XadielM/Xadiel_Martinez_PLC4Uni/Tarea 4/Imagenes/PLC4UNI Demo.png

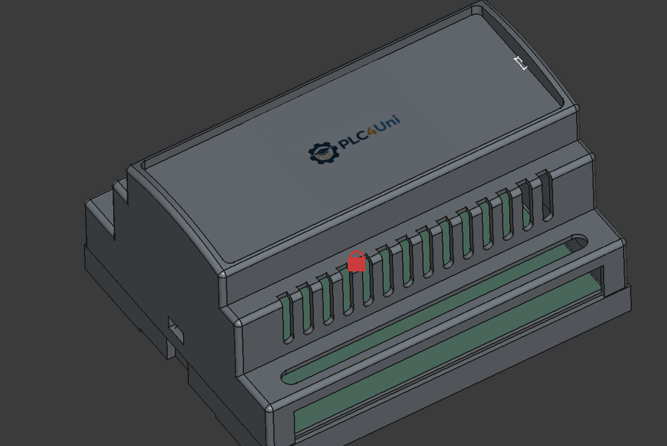
Tarea 4/Imagenes/PLC4UNI Demo.png
