XadielM/Xadiel_Martinez_PLC4Uni/Tarea 5/Etiqueta frontal.jpg

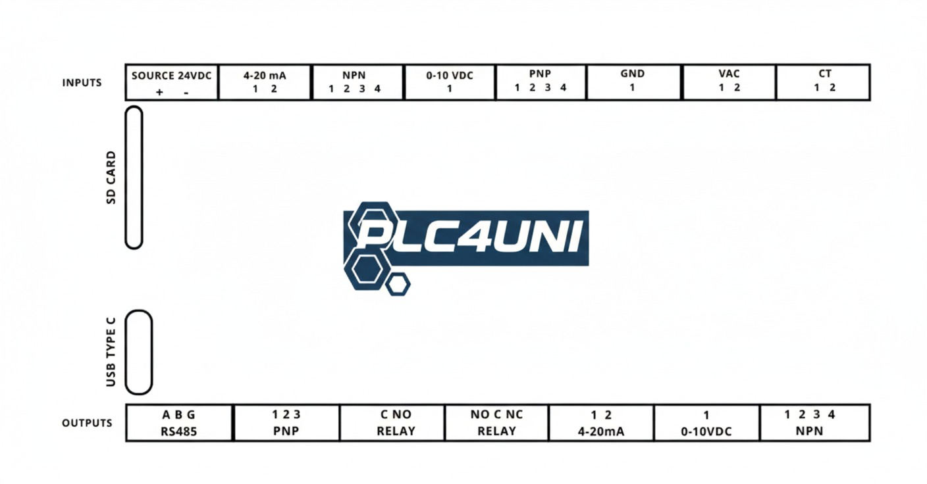
Tarea 5/Etiqueta frontal.jpg
