XadielM/Xadiel_Martinez_PLC4Uni/Tarea 5/Etiqueta lateral.png

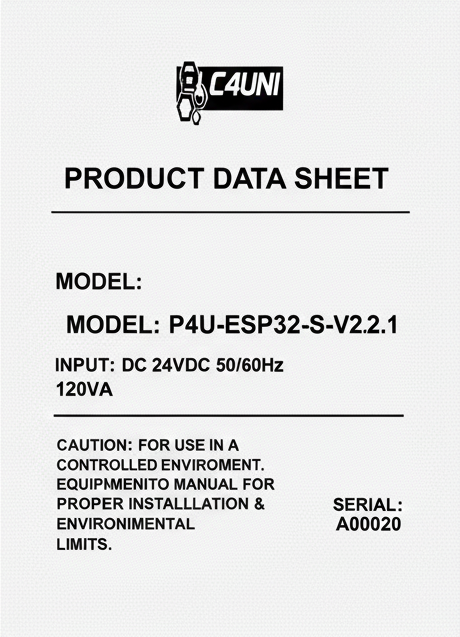
Tarea 5/Etiqueta lateral.png
