XadielM/Xadiel_Martinez_PLC4Uni/Tarea 2/Diseño del plastic case/FreeCAD/Plastic Case PT1.FCStd

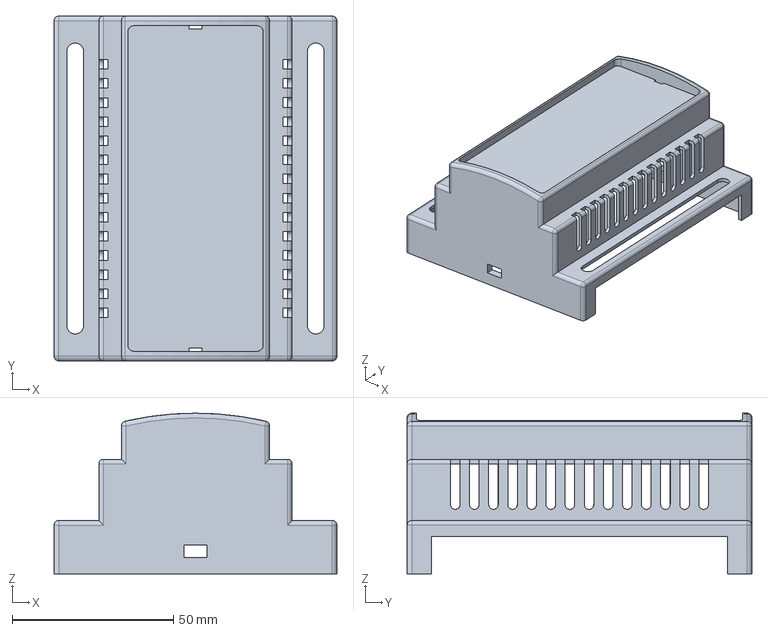
[picture p10: CAD file, 2025-10-10]
Tarea 2/Diseño del plastic case/FreeCAD/Plastic Case PT1.FCStd
87.7 x 107.0 x 49.8 mm
