XadielM/Xadiel_Martinez_PLC4Uni/Tarea 2/Diseño del plastic case/FreeCAD/Plastic Case PT2.FCStd

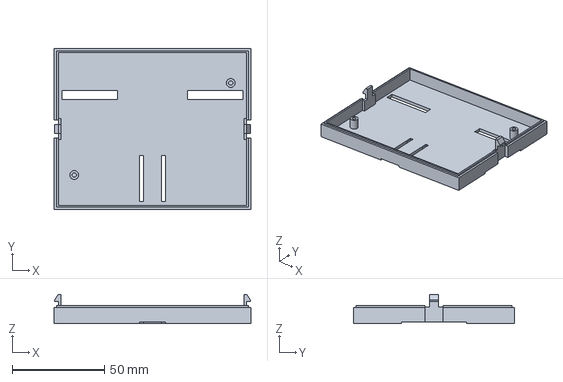
[picture p11: CAD file, 2025-10-03]
Tarea 2/Diseño del plastic case/FreeCAD/Plastic Case PT2.FCStd
107.0 x 87.7 x 16.0 mm
