XadielM/Xadiel_Martinez_PLC4Uni/Tarea 2/Diseño del plastic case/FreeCAD/Plastic Case PT3.FCStd

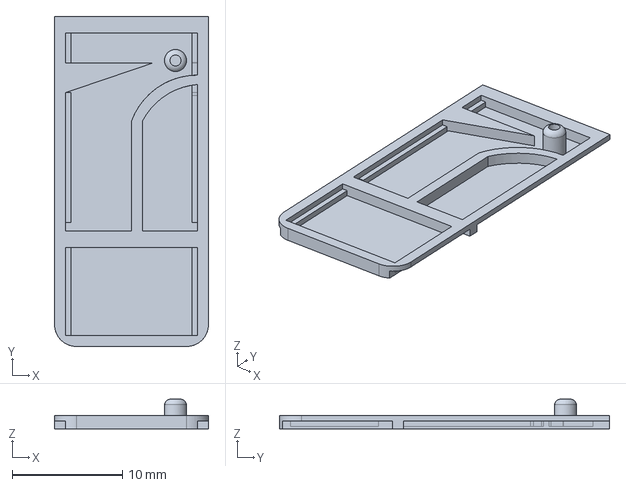
[picture p12: CAD file, 2025-10-03]
Tarea 2/Diseño del plastic case/FreeCAD/Plastic Case PT3.FCStd
14.0 x 30.0 x 2.70 mm
