XadielM/Xadiel_Martinez_PLC4Uni/(list of files, cad)

Other CAD files:
Tarea 4/Assembly.FCStd
Tarea 6/Assembly.FCStd
