XadielM/Xadiel_Martinez_PLC4Uni/Tarea 5/PLC4UNI Manual Edicion 1.0.docx

Manual de uso Edición 1.0

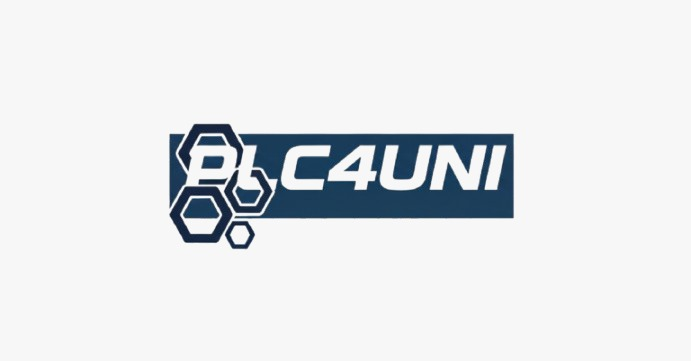
[picture p13: figure]

Gracias por elegir PLC4UNI para tus proyectos universitarios y/o personales, en este manual encontrarás todo lo relacionado al PLC para poder aprovechar sus capacidades al máximo.

# Introducción

## Descripción

PLC4UNI es un PLC de código abierto enfocado en el ámbito educación superior desarrollado por estudiantes del Instituto Tecnológico de Las Américas (ITLA). De ahí es donde viene el nombre PLC4UNI o PLC for University lo cual significa PLC para Universidad.

El PLC utiliza ESP32 como CPU, logrando así un dispositivo de automatización compacta y de código abierto. Gracias al ESP32 el cual es un microcontrolador potente también brinda buena conectividad WiFi y Bluetooth para aplicaciones de la industria 4.0 y IoT (Internet of Things). El sistema completo esta integrado en una PCB diseñada a medida, que incorpora las entradas y salidas y asegura la protección y fiabilidad de las señales.

## Proposito del dispositivo

Este dispositivo busca ser de costo asequible para los estudiantes debido a su enfoque educativo sin quitarle su funcionalidad básica de un PLC industrial, este es el dispositivo perfecto como introducción a PLC para estudiantes.

## Definiciones, acrónimos y abreviaturas

PLC: (Programmable Logic Controller) Dispositivo robusto que automatiza tareas comúnmente usado en el área industrial, como puede ser: controlar máquinas, motores eléctricos, etc.

IoT: Es una red de objetos conectados a internet que mediante software y sensores son capaces de recopilar, intercambiar datos y actuar de forma inteligente, los cuales van desde electrodomésticos hasta maquinas industriales para automatizar tareas.

PCB: (Printed Circuit Board). Es una placa plana hecha de material aislante con pistas de material conductor en la superficie, mayormente de cobre. Esta placa se conoce como la base mediante la cual se conectan y se montan los componentes electrónicos.

CPU: (Central Processing Unit). Es el cerebro de una computadora, lo que significa que es el componente principal que ejecuta instrucciones, realiza cálculos y gestiona las tareas de un dispositivo.

ESP32: Es un microcontrolador de bajo costo que cuenta con conectividad Bluetooth y WiFi

Microcontrolador: Es una pequeña computadora diseñada para ejecutar tareas específicas de forma autónoma.

Din rail: Barra metálica estandarizada, principalmente de acero, utilizada para montar de forma rápida y organizada componentes eléctricos y de automatización

## Propósito del manual

Este documento esta enfocado a estudiantes de ingeniería, técnicos y personas entusiastas los cuales estén interesados en entender y programar este dispositivo. Tiene como propósito ser una guía concisa y práctica para el inicio de forma segura y eficiente del PLC, desde las conexiones hasta la ejecución del primer programa.

## Características principales

Conectividad: Increíble capacidad inalámbricas gracias al ESP32 que cuenta con WiFI 802.11 b/g/n y Bluetooth v4.2.

Diseño robusto: PCB diseñada para aplicaciones educativas que cuenta con buena resistencia para tareas con nivel medio de demanda y que cuenta con terminales de tornillo y din rail para instalación en cualquier tipo de panel.

Nucleo de alto rendimiento: Gracias al ESP32 que cuenta con doble núcleo a 240MHz.

# Arquitectura y Hardware

## Bloques del sistema

El sistema se compone de tres secciones principales los cuales interactúan con la CPU, los cuales son, alimentación, Interfaz de entrada y interfaz de salida.

    - Alimentación: Es la que proporciona la energía necesaria para el sistema lógico, a las entradas y salidas. Es lo que hace que todos los componentes funcionen.
    - Interfaz de entrada: Recibe y acondiciona las señales y las lleva al nivel lógico que tiene el ESP32 para ser procesadas y ejecutar acciones según las instrucciones que tenga.
    - Interfaz de salida: Luego del ESP32 procesar las señales, manda señales a estas salidas según las instrucciones que tenga el PLC.

## Especificaciones técnicas

Alimentación I/O: La alimentación general son 24V y al ESP32 son 3.3V, lo indicado por el manual del ESP.

Entradas digitales: Tenemos distintos tipos de entradas, desde simples entradas PNP hasta entradas optocupladas, entre otras.

Salidas digitales: De igual formas encontramos una buena variedad de salidas, desde RS485 hasta salidas a Relay y 0-10V.

Dimensiones de la PCB:

- Circuito del USB: Largo 44.5 x Ancho16 mm
- Circuito principal: Largo 99.9 x Ancho 80.1 mm

# Input Interface

## Entradas

Pin Number | Label | Función o Descripción
1 | 24V | Alimentación 24V
2 | GND | Tierra
3 | 4-20mA | Entrada de corriente 4-20mA
4 | GND | Tierra
5 | NPN_IN | Entrada NPN
6 | NPN_IN | Entrada NPN
7 | NPN_IN | Entrad NPN
8 | NPN_IN | Entrada NPN
9 | 0-10V | Entrada de voltaje 0-10V
10 | PNP_IN | Entrada PNP
11 | PNP_IN | Entrada PNP
12 | PNP_IN | Entrada PNP
13 | PNP_IN | Entrada PNP
14 | GND | Tierra
15 | VAC1 | Entrada Voltaje AC
16 | VAC2 | Entrada Voltaje AC
17 | CT1 | EntradaCT
18 | CT2 | Entrada CT

## Salidas:

Pin Number | Label | Función o Descripción
1 | RS485_A | Transmisión serial RS485
2 | RS485_B | Transmisión serial RS485
3 | GND | Tierra
4 | PNP_OUT | Salida PNP
5 | PNP_OUT | Salida PNP
6 | PNP_OUT | Salida PNP
7 | NO_B_RLY | Relay B Normally Open
8 | COM_B_RLY | Relay B Comun
9 | NC_B_RLY | Relay B Normally Closed
10 | COM_A_RLY | Relay A comun
11 | NO_RLY | Relay A Normall Open
12 | 4-20mA | Salida corriente 4-20mA
13 | GND | Tierra
14 | 0-10V | Salida de voltaje 0-10V
15 | NPN_OUT | Salida NPN
16 | NPN_OUT | Salida NPN
17 | NPN_OUT | Salida NPN
18 | NPN_OUT | Salida NPN

# Funcionalidades Avanzadas

## Conectividad inalámbrica

- Servidor Web: Ideal para cambiar o monitorear el estado de las Entradas y Salidas desde un navegador.
- Protocolo MQTT: Sirve para enviar datos de entrada a la nube o a un sistema SCADA.
- Modbus TCP/IP: Implementación de protocolos industriales estándar sobre WiFi.

## Modos especiales

Entradas Analógicas: Aunque las mayorías de las entradas del ESP son digitales con los pines analógicos que tiene el microcontrolador pueden ser usados para sensores que se regulan de 0 a 3.3V (voltaje máximo 3.3 para el uso correcto y evitar dañar el ESP).

PWM: El ESP32 soporta PWM en varios de sus pines lo cual permite controlar diferentes velocidades de motores y hasta la intensidad de luces, entre otras diferentes aplicaciones que se podrían hacer con esta función.

# Mantenimiento básico

Revisión. Asegurarse siempre que las terminales de tornillos estén bien ajustadas y que luzcan en buenas condiciones antes de conectar cualquier cosa.

Limpieza. Siempre es muy importante mantener la PCB libre de polvo y humedad. También mantener alejado de zonas muy calurosas para así evitar daños internos tanto a conexiones como a componentes.

Seguridad. Desconectar siempre la alimentación a 24V antes de mover o hacer algún tipo de ajuste en alguna entrada o salida.

# Bibliografías

PLC4UNI

https://github.com/XadielM/Xadiel_Martinez_PLC4Uni.git

Espressif https://www.espressif.com/sites/default/files/documentation/esp32_datasheet_en.pdf

ESP32 Datasheet

https://www.alldatasheet.com/view.jsp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
