XadielM/Xadiel_Martinez_PLC4Uni/Tarea 3/Diseño PCB/PLC4UNI/PLC4UNI.kicad_pcb

## KiCad design Tarea 3/Diseño PCB/PLC4UNI/PLC4UNI.kicad_pcb (2025-12-11)

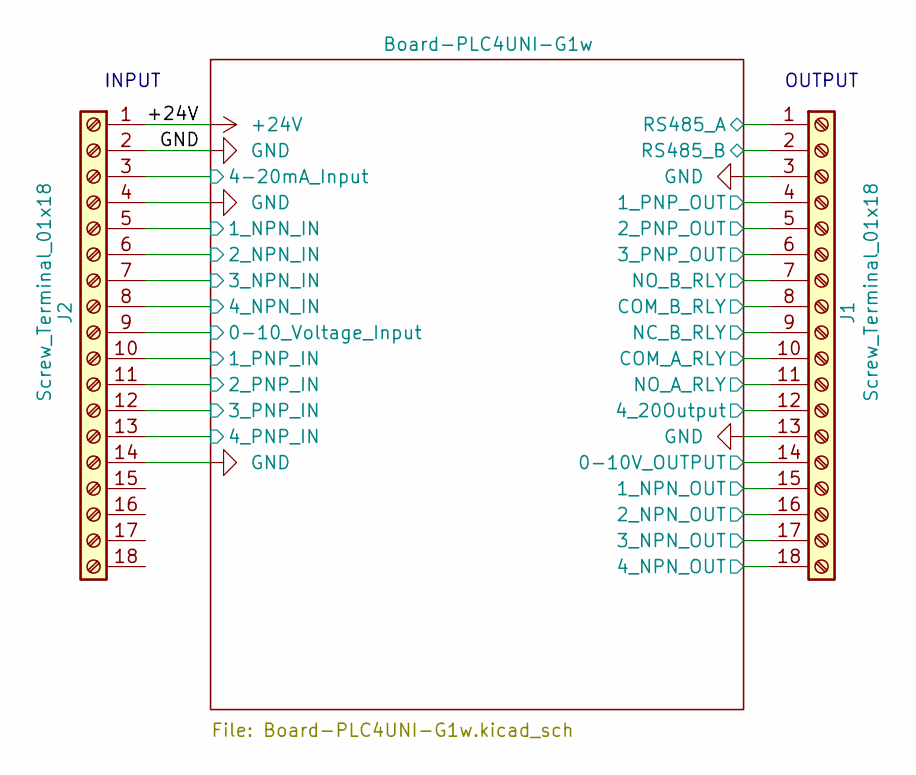
[picture p14: schematic PLC4UNI.kicad_sch]

Parts:
J1, J2: Screw_Terminal_01x18; TerminalBlock_MaiXu_MX126-5.0-18P_1x18_P5.00mm

Connections:
+24V: J2.1
/Board-PLC4UNI-G1w/0-10V_OUTPUT: J1.14; also elsewhere on the board
/Board-PLC4UNI-G1w/0-10_Voltage_Input: J2.9; also elsewhere on the board
/Board-PLC4UNI-G1w/1_NPN_IN: J2.5; also elsewhere on the board
/Board-PLC4UNI-G1w/1_NPN_OUT: J1.15; also elsewhere on the board
/Board-PLC4UNI-G1w/1_PNP_IN: J2.10; also elsewhere on the board
/Board-PLC4UNI-G1w/1_PNP_OUT: J1.4; also elsewhere on the board
/Board-PLC4UNI-G1w/2_NPN_IN: J2.6; also elsewhere on the board
/Board-PLC4UNI-G1w/2_NPN_OUT: J1.16; also elsewhere on the board
/Board-PLC4UNI-G1w/2_PNP_IN: J2.11; also elsewhere on the board
/Board-PLC4UNI-G1w/2_PNP_OUT: J1.5; also elsewhere on the board
/Board-PLC4UNI-G1w/3_NPN_IN: J2.7; also elsewhere on the board
/Board-PLC4UNI-G1w/3_NPN_OUT: J1.17; also elsewhere on the board
/Board-PLC4UNI-G1w/3_PNP_IN: J2.12; also elsewhere on the board
/Board-PLC4UNI-G1w/3_PNP_OUT: J1.6; also elsewhere on the board
/Board-PLC4UNI-G1w/4-20mA_Input: J2.3; also elsewhere on the board
/Board-PLC4UNI-G1w/4_20Output: J1.12; also elsewhere on the board
/Board-PLC4UNI-G1w/4_NPN_IN: J2.8; also elsewhere on the board
/Board-PLC4UNI-G1w/4_NPN_OUT: J1.18; also elsewhere on the board
/Board-PLC4UNI-G1w/4_PNP_IN: J2.13; also elsewhere on the board
/Board-PLC4UNI-G1w/COM_A_RLY: J1.10; also elsewhere on the board
/Board-PLC4UNI-G1w/COM_B_RLY: J1.8; also elsewhere on the board
/Board-PLC4UNI-G1w/NC_B_RLY: J1.9; also elsewhere on the board
/Board-PLC4UNI-G1w/NO_A_RLY: J1.11; also elsewhere on the board
/Board-PLC4UNI-G1w/NO_B_RLY: J1.7; also elsewhere on the board
/Board-PLC4UNI-G1w/RS485_A: J1.1
/Board-PLC4UNI-G1w/RS485_B: J1.2; also elsewhere on the board
GND: J1.3, J1.13, J2.2, J2.4, J2.14; also elsewhere on the board

Notes on the sheet:
OUTPUT
INPUT

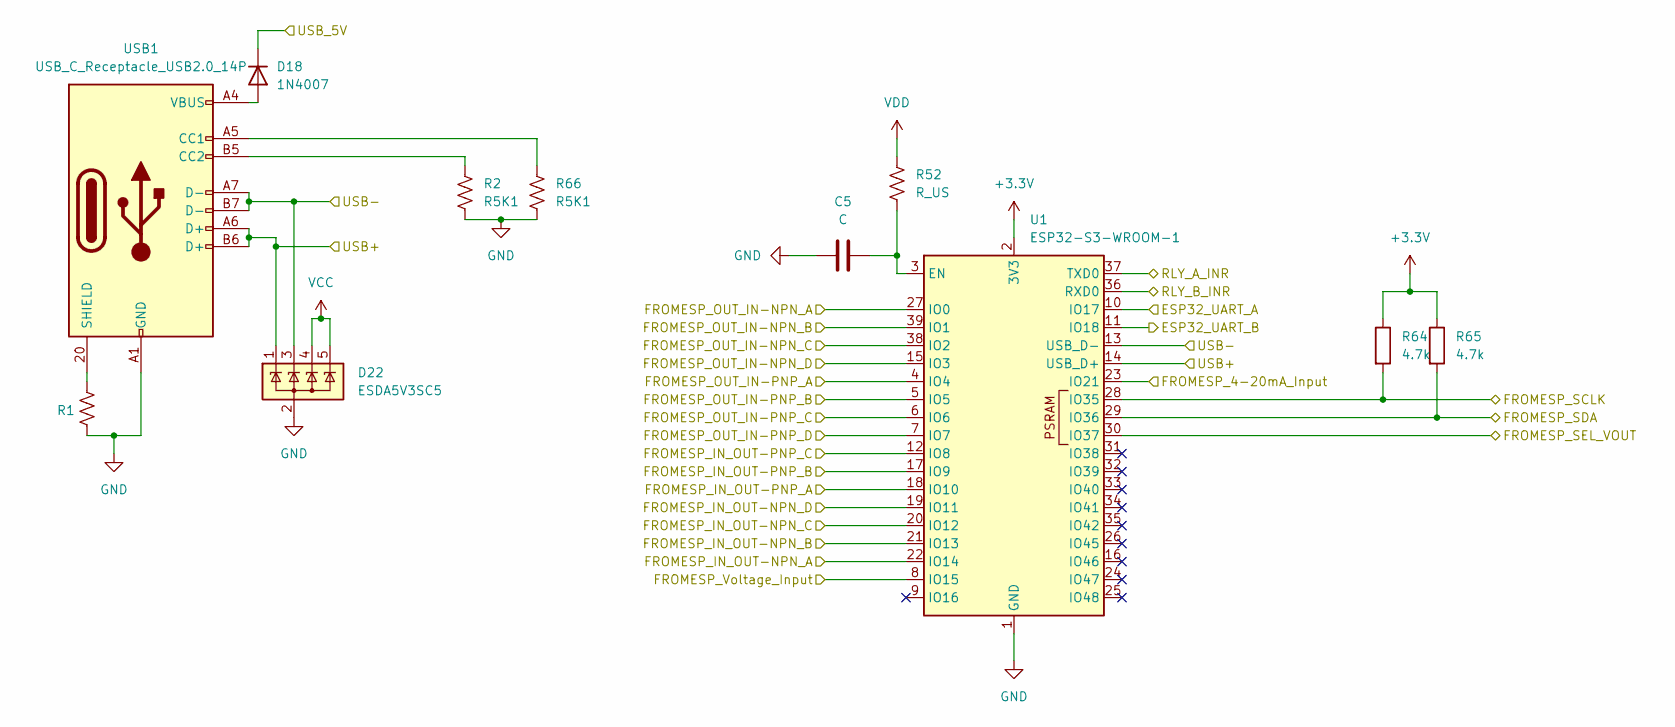
[picture p15: schematic PLC4UNI_CPU.kicad_sch]

Parts:
C5: C; C_1206_3216Metric_Pad1.33x1.80mm_HandSolder
D18: 1N4007; D_0603_1608Metric_Pad1.05x0.95mm_HandSolder
D22: ESDA5V3SC5; SOT-23-5
R1, R2, R66: R5K1; R_0201_0603Metric
R52: R_US; R_0201_0603Metric
R64, R65: 4.7k; R_0603_1608Metric
U1: ESP32-S3-WROOM-1
USB1: USB_C_Receptacle_USB2.0_14P; USB_C_Receptacle_HRO_TYPE-C-31-M-12

Connections:
+3.3V: R64.1, R65.1, U1.2 (3V3); also elsewhere on the board
/Board-PLC4UNI-G1w/0-10V_Output/SCLK_V: R64.2, U1.28 (IO35); also elsewhere on the board
/Board-PLC4UNI-G1w/0-10V_Output/SDA_V: R65.2, U1.29 (IO36); also elsewhere on the board
/Board-PLC4UNI-G1w/0-10V_Output/SEL: U1.30 (IO37); also elsewhere on the board
/Board-PLC4UNI-G1w/0-10_Input/Voltage_Input_toESP: U1.8 (IO15); also elsewhere on the board
/Board-PLC4UNI-G1w/4-20mA_Input/4-20mA_toESP_IN: U1.23 (IO21); also elsewhere on the board
/Board-PLC4UNI-G1w/OUT_RLY_A/RLY_A_INR: U1.37 (TXD0); also elsewhere on the board
/Board-PLC4UNI-G1w/OUT_RLY_B/RLY_B_INR: U1.36 (RXD0); also elsewhere on the board
/Board-PLC4UNI-G1w/PLC4UNI_CPU/ESP32_UART_A: U1.10 (IO17); also elsewhere on the board
/Board-PLC4UNI-G1w/PLC4UNI_CPU/ESP32_UART_B: U1.11 (IO18); also elsewhere on the board
/Board-PLC4UNI-G1w/PLC4UNI_CPU/FROMESP_IN_OUT-NPN_A: U1.22 (IO14); also elsewhere on the board
/Board-PLC4UNI-G1w/PLC4UNI_CPU/FROMESP_IN_OUT-NPN_B: U1.21 (IO13); also elsewhere on the board
/Board-PLC4UNI-G1w/PLC4UNI_CPU/FROMESP_IN_OUT-NPN_C: U1.20 (IO12); also elsewhere on the board
/Board-PLC4UNI-G1w/PLC4UNI_CPU/FROMESP_IN_OUT-NPN_D: U1.19 (IO11); also elsewhere on the board
/Board-PLC4UNI-G1w/PLC4UNI_CPU/FROMESP_IN_OUT-PNP_A: U1.18 (IO10); also elsewhere on the board
/Board-PLC4UNI-G1w/PLC4UNI_CPU/FROMESP_IN_OUT-PNP_B: U1.17 (IO9); also elsewhere on the board
/Board-PLC4UNI-G1w/PLC4UNI_CPU/FROMESP_IN_OUT-PNP_C: U1.12 (IO8); also elsewhere on the board
/Board-PLC4UNI-G1w/PLC4UNI_CPU/FROMESP_OUT_IN-NPN_A: U1.27 (IO0); also elsewhere on the board
/Board-PLC4UNI-G1w/PLC4UNI_CPU/FROMESP_OUT_IN-NPN_B: U1.39 (IO1); also elsewhere on the board
/Board-PLC4UNI-G1w/PLC4UNI_CPU/FROMESP_OUT_IN-NPN_C: U1.38 (IO2); also elsewhere on the board
/Board-PLC4UNI-G1w/PLC4UNI_CPU/FROMESP_OUT_IN-NPN_D: U1.15 (IO3); also elsewhere on the board
/Board-PLC4UNI-G1w/PLC4UNI_CPU/FROMESP_OUT_IN-PNP_A: U1.4 (IO4); also elsewhere on the board
/Board-PLC4UNI-G1w/PLC4UNI_CPU/FROMESP_OUT_IN-PNP_B: U1.5 (IO5); also elsewhere on the board
/Board-PLC4UNI-G1w/PLC4UNI_CPU/FROMESP_OUT_IN-PNP_C: U1.6 (IO6); also elsewhere on the board
/Board-PLC4UNI-G1w/PLC4UNI_CPU/FROMESP_OUT_IN-PNP_D: U1.7 (IO7); also elsewhere on the board
/Board-PLC4UNI-G1w/PLC4UNI_CPU/USB+: D22.1 (K), U1.14 (USB_D+), USB1.A6 (D+), USB1.B6 (D+)
/Board-PLC4UNI-G1w/PLC4UNI_CPU/USB-: D22.3 (K), U1.13 (USB_D-), USB1.A7 (D-), USB1.B7 (D-)
/Board-PLC4UNI-G1w/PLC4UNI_CPU/USB_5V: D18.1 (K)
GND: C5.1, D22.2 (A), R1.2, R2.2, R66.2, U1.1 (GND), U1.40 (GND), U1.41 (GND), USB1.A1 (GND), USB1.A12 (GND), USB1.B1 (GND), USB1.B12 (GND); also elsewhere on the board
unnamed: D18.2 (A), USB1.A4 (VBUS), USB1.A9 (VBUS), USB1.B4 (VBUS), USB1.B9 (VBUS)
unnamed: C5.2, R52.2, U1.3 (EN)
unnamed: R66.1, USB1.A5 (CC1)
unnamed: R2.1, USB1.B5 (CC2)
unnamed: R1.1, USB1.20 (SHIELD)
VCC: D22.4 (K), D22.5 (K); also elsewhere on the board
VDD: R52.1

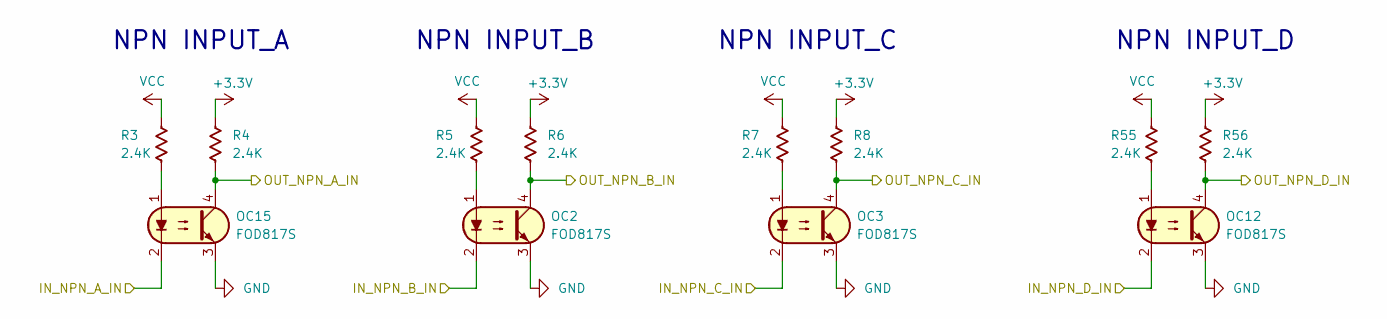
[picture p16: schematic input_NPN.kicad_sch]

Parts:
OC2, OC3, OC12, OC15: FOD817S; SMDIP-4_W9.53mm
R3, R4, R5, R6, R7, R8, R55, R56: 2.4K; R_0603_1608Metric

Connections:
+3.3V: R4.2, R6.2, R8.2, R56.2; also elsewhere on the board
/Board-PLC4UNI-G1w/1_NPN_IN: OC15.2; also elsewhere on the board
/Board-PLC4UNI-G1w/2_NPN_IN: OC2.2; also elsewhere on the board
/Board-PLC4UNI-G1w/3_NPN_IN: OC3.2; also elsewhere on the board
/Board-PLC4UNI-G1w/4_NPN_IN: OC12.2; also elsewhere on the board
/Board-PLC4UNI-G1w/PLC4UNI_CPU/FROMESP_OUT_IN-NPN_A: OC15.4, R4.1; also elsewhere on the board
/Board-PLC4UNI-G1w/PLC4UNI_CPU/FROMESP_OUT_IN-NPN_B: OC2.4, R6.1; also elsewhere on the board
/Board-PLC4UNI-G1w/PLC4UNI_CPU/FROMESP_OUT_IN-NPN_C: OC3.4, R8.1; also elsewhere on the board
/Board-PLC4UNI-G1w/PLC4UNI_CPU/FROMESP_OUT_IN-NPN_D: OC12.4, R56.1; also elsewhere on the board
GND: OC2.3, OC3.3, OC12.3, OC15.3; also elsewhere on the board
unnamed: OC2.1, R5.2
unnamed: OC3.1, R7.2
unnamed: OC12.1, R55.2
unnamed: OC15.1, R3.2
VCC: R3.1, R5.1, R7.1, R55.1; also elsewhere on the board

Notes on the sheet:
NPN INPUT_D
NPN INPUT_A
NPN INPUT_B
NPN INPUT_C

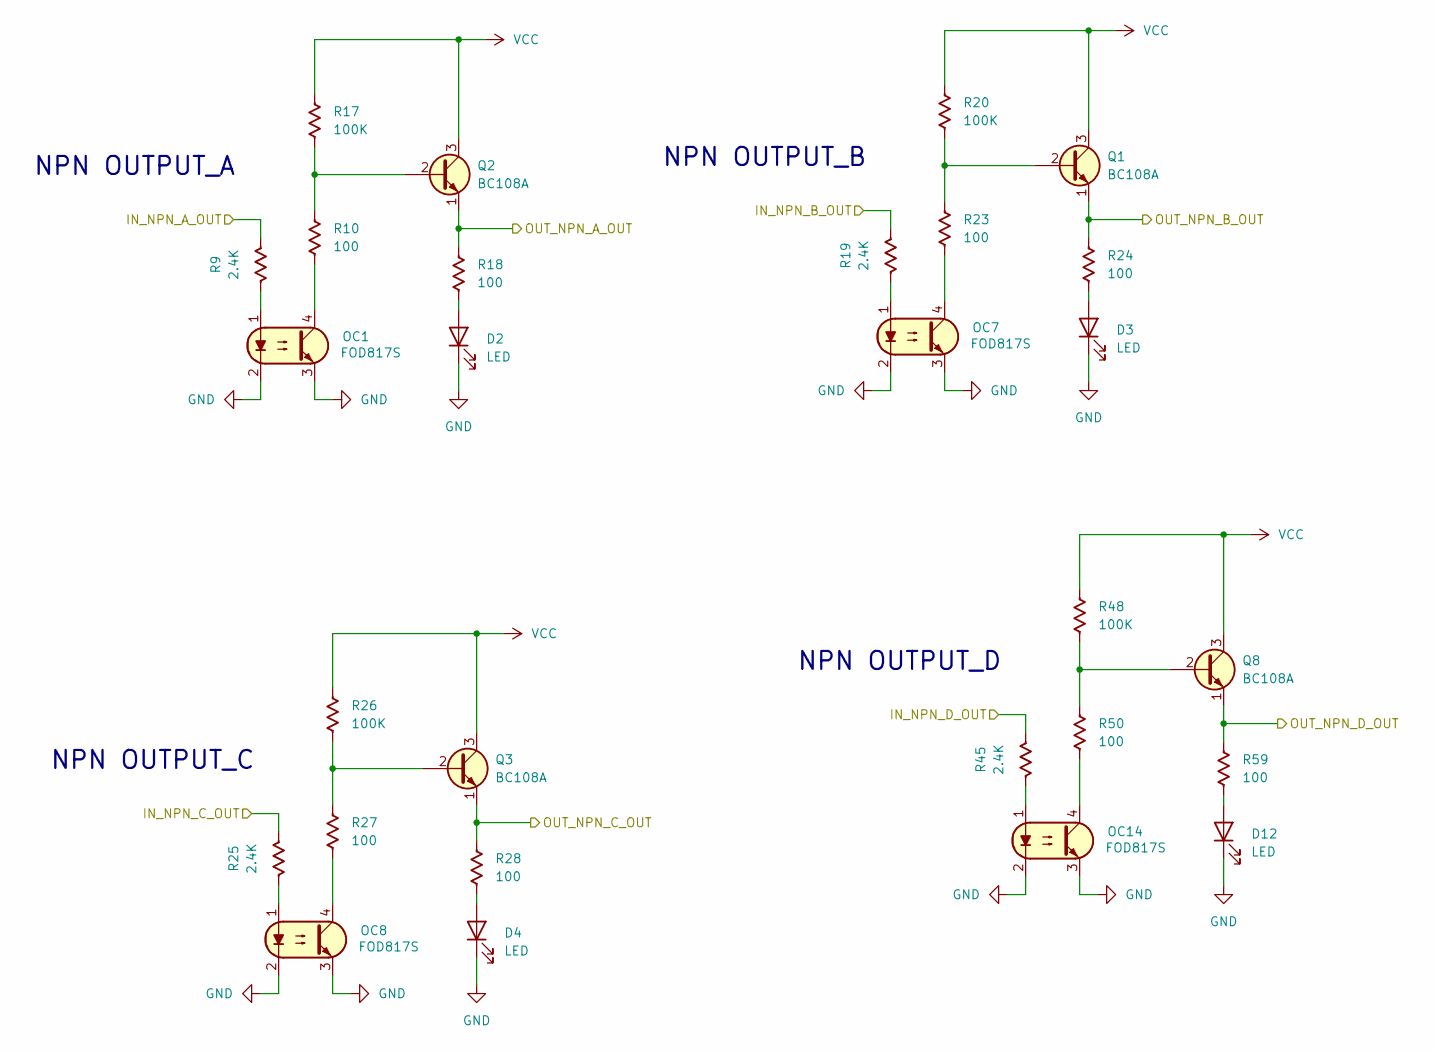
[picture p17: schematic output_NPN.kicad_sch]

Parts:
D2, D3, D4, D12: LED; LED_0603_1608Metric
OC1, OC7, OC8, OC14: FOD817S; SMDIP-4_W9.53mm
Q1, Q2, Q3, Q8: BC108A; TO-18-3_EBC
R9, R19, R25, R45: 2.4K; R_0603_1608Metric
R10, R18, R23, R24, R27, R28, R50, R59: 100; R_0603_1608Metric
R17, R20, R26, R48: 100K; R_0603_1608Metric

Connections:
/Board-PLC4UNI-G1w/1_NPN_OUT: Q2.1 (E), R18.2; also elsewhere on the board
/Board-PLC4UNI-G1w/2_NPN_OUT: Q1.1 (E), R24.2; also elsewhere on the board
/Board-PLC4UNI-G1w/3_NPN_OUT: Q3.1 (E), R28.2; also elsewhere on the board
/Board-PLC4UNI-G1w/4_NPN_OUT: Q8.1 (E), R59.2; also elsewhere on the board
/Board-PLC4UNI-G1w/PLC4UNI_CPU/FROMESP_IN_OUT-NPN_A: R9.1; also elsewhere on the board
/Board-PLC4UNI-G1w/PLC4UNI_CPU/FROMESP_IN_OUT-NPN_B: R19.1; also elsewhere on the board
/Board-PLC4UNI-G1w/PLC4UNI_CPU/FROMESP_IN_OUT-NPN_C: R25.1; also elsewhere on the board
/Board-PLC4UNI-G1w/PLC4UNI_CPU/FROMESP_IN_OUT-NPN_D: R45.1; also elsewhere on the board
GND: D2.1 (K), D3.1 (K), D4.1 (K), D12.1 (K), OC1.2, OC1.3, OC7.2, OC7.3, OC8.2, OC8.3, OC14.2, OC14.3; also elsewhere on the board
unnamed: D2.2 (A), R18.1
unnamed: D3.2 (A), R24.1
unnamed: D4.2 (A), R28.1
unnamed: D12.2 (A), R59.1
unnamed: OC1.1, R9.2
unnamed: OC1.4, R10.1
unnamed: OC7.1, R19.2
unnamed: OC7.4, R23.1
unnamed: OC8.1, R25.2
unnamed: OC8.4, R27.1
unnamed: OC14.1, R45.2
unnamed: OC14.4, R50.1
unnamed: Q1.2 (B), R20.1, R23.2
unnamed: Q2.2 (B), R10.2, R17.1
unnamed: Q3.2 (B), R26.1, R27.2
unnamed: Q8.2 (B), R48.1, R50.2
VCC: Q1.3 (C), Q2.3 (C), Q3.3 (C), Q8.3 (C), R17.2, R20.2, R26.2, R48.2; also elsewhere on the board

Notes on the sheet:
NPN OUTPUT_B
NPN OUTPUT_D
NPN OUTPUT_C
NPN OUTPUT_A

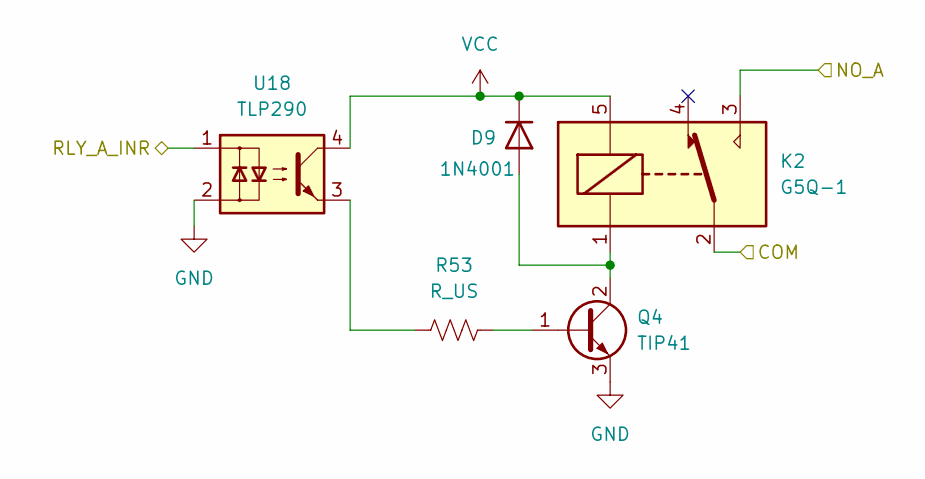
[picture p18: schematic OUT_RLY_A.kicad_sch]

Parts:
D9: 1N4001; D_DO-41_SOD81_P10.16mm_Horizontal
K2: G5Q-1; Relay_SPDT_Omron-G5Q-1
Q4: TIP41; TO-220-3_Vertical
R53: R_US; R_0201_0603Metric
U18: TLP290; SOP-4_4.4x2.6mm_P1.27mm

Connections:
/Board-PLC4UNI-G1w/COM_A_RLY: K2.2; also elsewhere on the board
/Board-PLC4UNI-G1w/NO_A_RLY: K2.3; also elsewhere on the board
/Board-PLC4UNI-G1w/OUT_RLY_A/RLY_A_INR: U18.1; also elsewhere on the board
GND: Q4.3 (E), U18.2; also elsewhere on the board
unnamed: D9.2 (A), K2.1, Q4.2 (C)
unnamed: Q4.1 (B), R53.2
unnamed: R53.1, U18.3
VCC: D9.1 (K), K2.5, U18.4; also elsewhere on the board

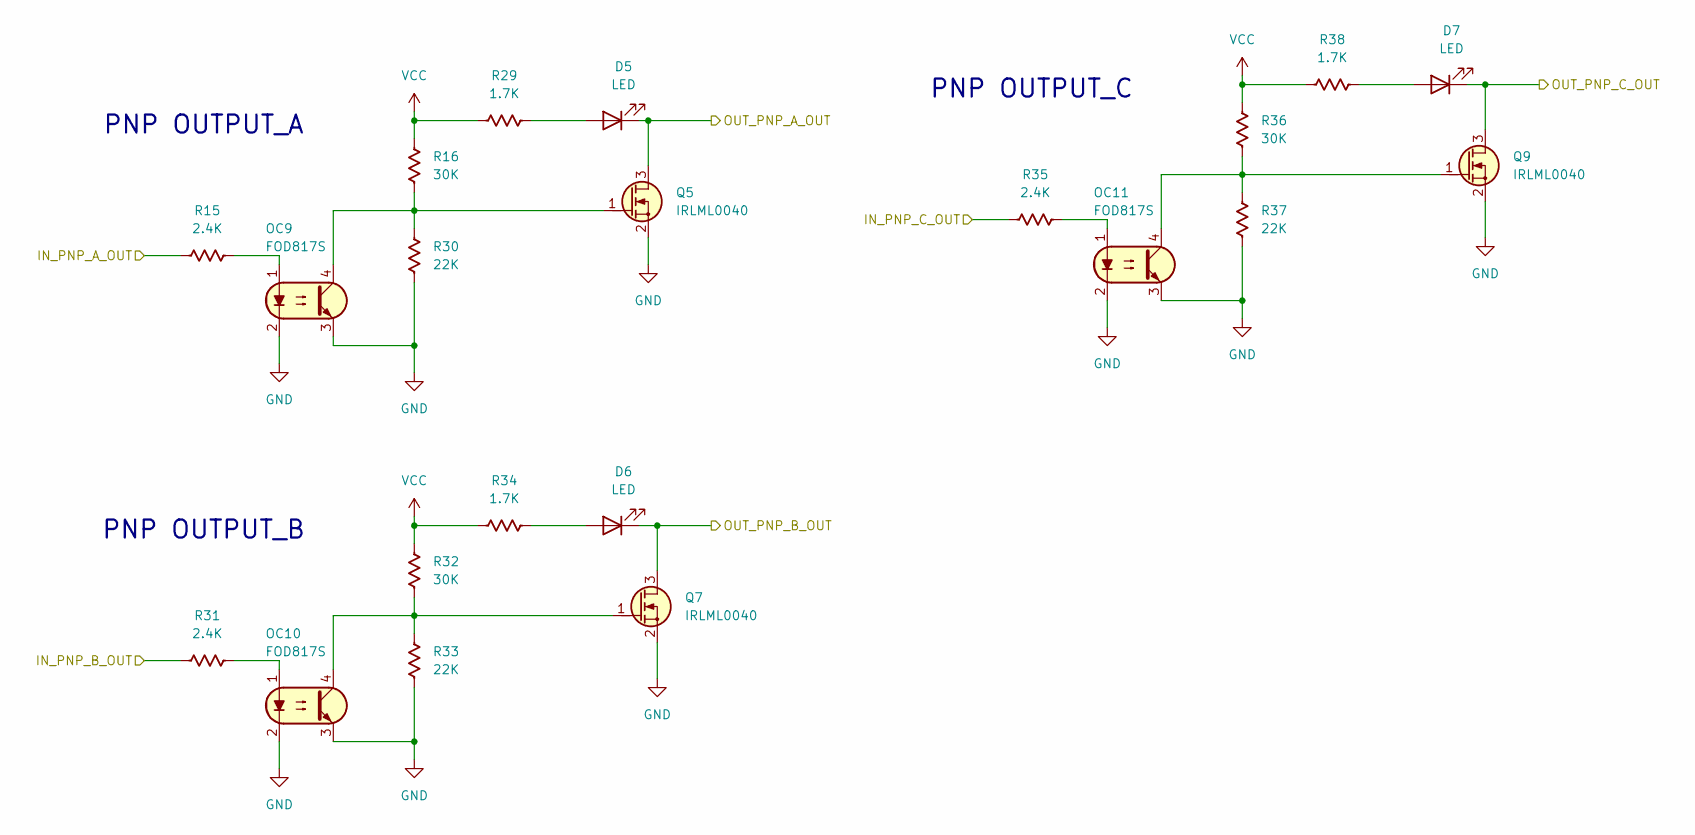
[picture p19: schematic output_PNP.kicad_sch]

Parts:
D5, D6, D7: LED; LED_0603_1608Metric
OC9, OC10, OC11: FOD817S; SMDIP-4_W9.53mm
Q5, Q7, Q9: IRLML0040; SOT-23
R15, R31, R35: 2.4K; R_0603_1608Metric
R16, R32, R36: 30K; R_0603_1608Metric
R29, R34, R38: 1.7K; R_0603_1608Metric
R30, R33, R37: 22K; R_0603_1608Metric

Connections:
/Board-PLC4UNI-G1w/1_PNP_OUT: D5.1 (K), Q5.3 (D); also elsewhere on the board
/Board-PLC4UNI-G1w/2_PNP_OUT: D6.1 (K), Q7.3 (D); also elsewhere on the board
/Board-PLC4UNI-G1w/3_PNP_OUT: D7.1 (K), Q9.3 (D); also elsewhere on the board
/Board-PLC4UNI-G1w/PLC4UNI_CPU/FROMESP_IN_OUT-PNP_A: R15.1; also elsewhere on the board
/Board-PLC4UNI-G1w/PLC4UNI_CPU/FROMESP_IN_OUT-PNP_B: R31.1; also elsewhere on the board
/Board-PLC4UNI-G1w/PLC4UNI_CPU/FROMESP_IN_OUT-PNP_C: R35.1; also elsewhere on the board
GND: OC9.2, OC9.3, OC10.2, OC10.3, OC11.2, OC11.3, Q5.2 (S), Q7.2 (S), Q9.2 (S), R30.1, R33.1, R37.1; also elsewhere on the board
unnamed: D5.2 (A), R29.1
unnamed: D6.2 (A), R34.1
unnamed: D7.2 (A), R38.1
unnamed: OC9.1, R15.2
unnamed: OC10.1, R31.2
unnamed: OC11.1, R35.2
unnamed: OC9.4, Q5.1 (G), R16.1, R30.2
unnamed: OC10.4, Q7.1 (G), R32.1, R33.2
unnamed: OC11.4, Q9.1 (G), R36.1, R37.2
VCC: R16.2, R29.2, R32.2, R34.2, R36.2, R38.2; also elsewhere on the board

Notes on the sheet:
PNP OUTPUT_C
PNP OUTPUT_B
PNP OUTPUT_A

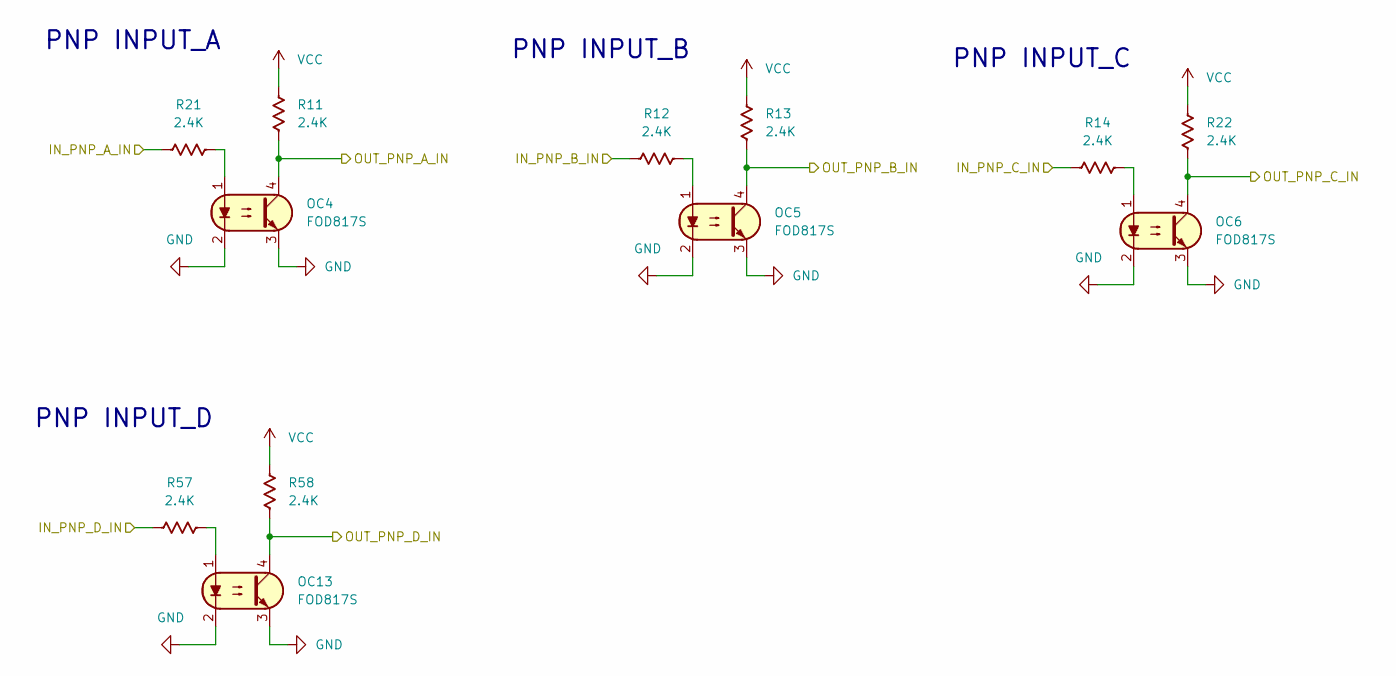
[picture p20: schematic input_PNP.kicad_sch]

Parts:
OC4, OC5, OC6, OC13: FOD817S; SMDIP-4_W9.53mm
R11, R12, R13, R14, R21, R22, R57: 2.4K; R_0603_1608Metric
R58: 2.4K; R_0201_0603Metric

Connections:
/Board-PLC4UNI-G1w/1_PNP_IN: R21.1; also elsewhere on the board
/Board-PLC4UNI-G1w/2_PNP_IN: R12.1; also elsewhere on the board
/Board-PLC4UNI-G1w/3_PNP_IN: R14.1; also elsewhere on the board
/Board-PLC4UNI-G1w/4_PNP_IN: R57.1; also elsewhere on the board
/Board-PLC4UNI-G1w/PLC4UNI_CPU/FROMESP_OUT_IN-PNP_A: OC4.4, R11.1; also elsewhere on the board
/Board-PLC4UNI-G1w/PLC4UNI_CPU/FROMESP_OUT_IN-PNP_B: OC5.4, R13.1; also elsewhere on the board
/Board-PLC4UNI-G1w/PLC4UNI_CPU/FROMESP_OUT_IN-PNP_C: OC6.4, R22.1; also elsewhere on the board
/Board-PLC4UNI-G1w/PLC4UNI_CPU/FROMESP_OUT_IN-PNP_D: OC13.4, R58.1; also elsewhere on the board
GND: OC4.2, OC4.3, OC5.2, OC5.3, OC6.2, OC6.3, OC13.2, OC13.3; also elsewhere on the board
unnamed: OC4.1, R21.2
unnamed: OC5.1, R12.2
unnamed: OC6.1, R14.2
unnamed: OC13.1, R57.2
VCC: R11.2, R13.2, R22.2, R58.2; also elsewhere on the board

Notes on the sheet:
PNP INPUT_B
PNP INPUT_D
PNP INPUT_A
PNP INPUT_C

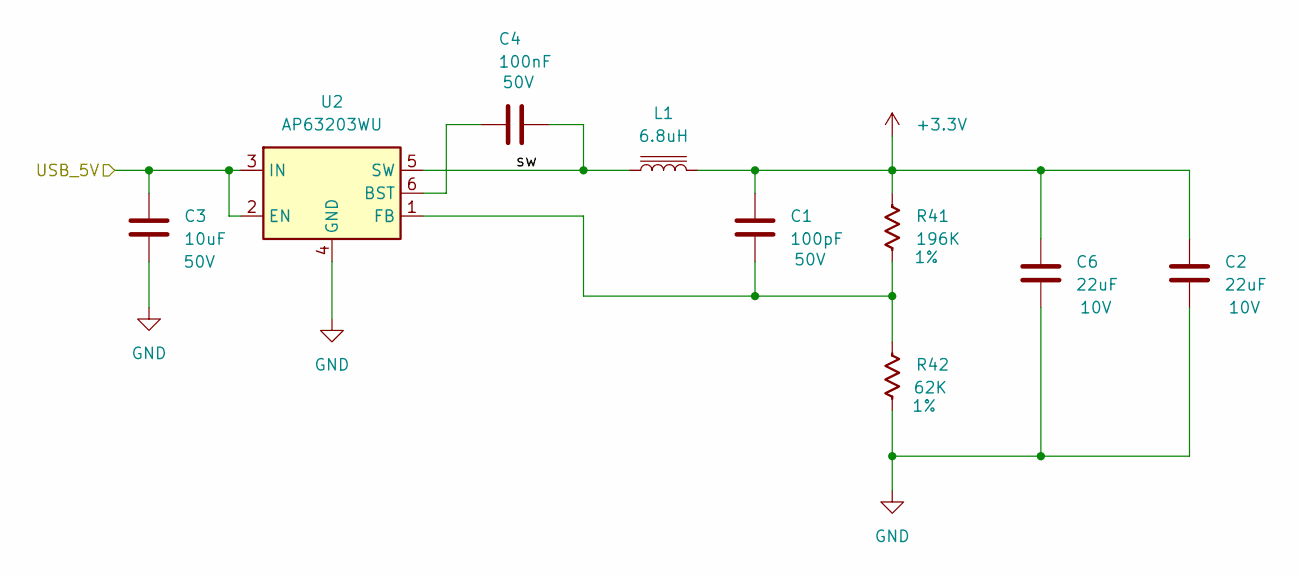
[picture p21: schematic PowerSupply.kicad_sch]

Parts:
C1: 100pF; C_0603_1608Metric
C2, C6: 22uF; C_0805
C3: 10uF; C_1206_3216Metric
C4: 100nF; C_0603_1608Metric
L1: 6.8uH; L_Chilisin_BMRA00040420; Part number SL0624-6R8M
R41: 196K; R_0603_1608Metric; Tolerancia 1%
R42: 62K; R_0603_1608Metric; Tolerancia 1%
U2: AP63203WU; TSOT-23-6

Connections:
+3.3V: C1.1, C2.1, C6.1, L1.1, R41.1; also elsewhere on the board
/Board-PLC4UNI-G1w/PowerSupply/USB_5V: C3.1, U2.2 (EN), U2.3 (IN)
/Board-PLC4UNI-G1w/PowerSupply/sw: C4.2, L1.2, U2.5 (SW)
GND: C2.2, C3.2, C6.2, R42.2, U2.4 (GND); also elsewhere on the board
unnamed: C4.1, U2.6 (BST)
unnamed: C1.2, R41.2, R42.1, U2.1 (FB)

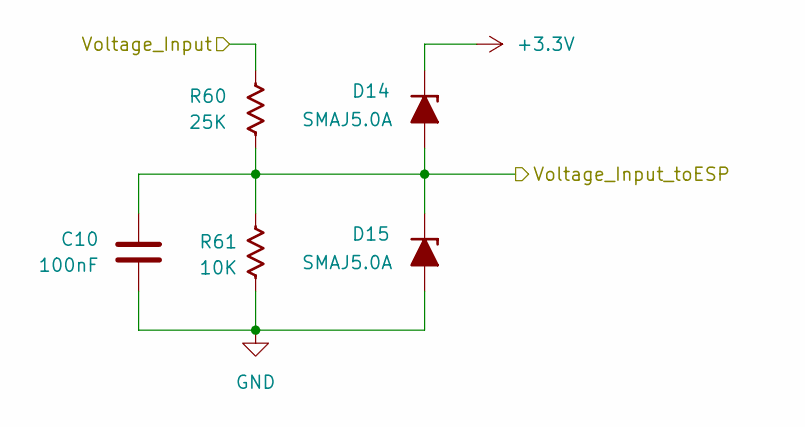
[picture p22: schematic 0-10_Input.kicad_sch]

Parts:
C10: 100nF; C_0603_1608Metric; Voltage 10V
D14, D15: SMAJ5.0A; D_SMA
R60: 25K; R_0603_1608Metric
R61: 10K; R_0603_1608Metric

Connections:
+3.3V: D14.1 (K); also elsewhere on the board
/Board-PLC4UNI-G1w/0-10_Input/Voltage_Input_toESP: C10.1, D14.2 (A), D15.1 (K), R60.1, R61.2; also elsewhere on the board
/Board-PLC4UNI-G1w/0-10_Voltage_Input: R60.2; also elsewhere on the board
GND: C10.2, D15.2 (A), R61.1; also elsewhere on the board

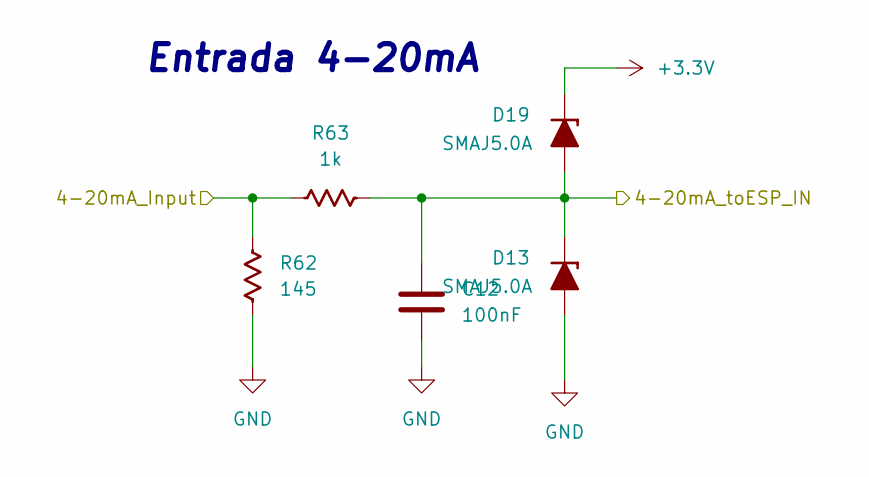
[picture p23: schematic 4-20mA_Input.kicad_sch]

Parts:
C12: 100nF; C_0603_1608Metric; Voltage 10V
D13, D19: SMAJ5.0A; D_SMA
R62: 145; R_0805_2012Metric
R63: 1k; R_0603_1608Metric

Connections:
+3.3V: D19.1 (K); also elsewhere on the board
/Board-PLC4UNI-G1w/4-20mA_Input: R62.1, R63.1; also elsewhere on the board
/Board-PLC4UNI-G1w/4-20mA_Input/4-20mA_toESP_IN: C12.1, D13.1 (K), D19.2 (A), R63.2; also elsewhere on the board
GND: C12.2, D13.2 (A), R62.2; also elsewhere on the board

Notes on the sheet:
Entrada 4-20mA

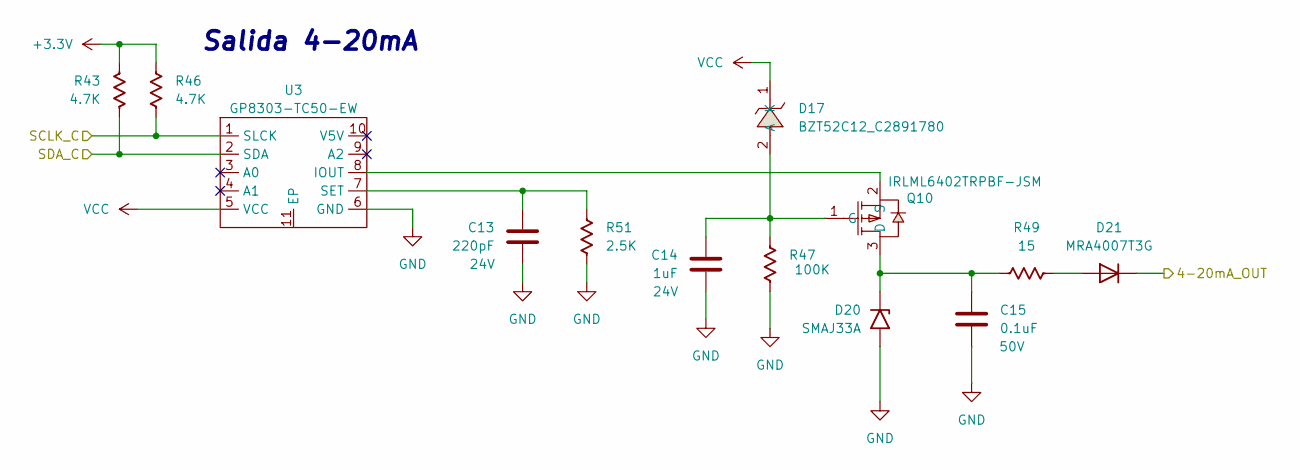
[picture p24: schematic 4-20mA_Output.kicad_sch]

Parts:
C13: 220pF; C_0805_2012Metric_Pad1.18x1.45mm_HandSolder
C14: 1uF; C_0603_1608Metric
C15: 0.1uF; C_0603_1608Metric
D17: BZT52C12_C2891780; D_SOD-123; LCSC Part C2891780
D20: SMAJ33A; D_SMA
D21: MRA4007T3G; D_SMA
Q10: IRLML6402TRPBF-JSM; SOT-23; LCSC Part C18190991
R43, R46: 4.7K; R_0603_1608Metric
R47: 100K; R_0603_1608Metric
R49: 15; R_0805_2012Metric
R51: 2.5K; R_0603_1608Metric
U3: GP8303-TC50-EW; SSOP-10_3.9x4.9mm_P1.00mm

Connections:
+3.3V: R43.1, R46.1; also elsewhere on the board
/Board-PLC4UNI-G1w/0-10V_Output/SCLK_V: R46.2, U3.1 (SLCK); also elsewhere on the board
/Board-PLC4UNI-G1w/0-10V_Output/SDA_V: R43.2, U3.2 (SDA); also elsewhere on the board
/Board-PLC4UNI-G1w/4_20Output: D21.1 (K); also elsewhere on the board
GND: C13.2, C14.2, C15.2, D20.2 (A2), R47.2, R51.2, U3.6 (GND); also elsewhere on the board
unnamed: C14.1, D17.2 (A), Q10.1 (G), R47.1
unnamed: C15.1, D20.1 (A1), Q10.3 (D), R49.1
unnamed: D21.2 (A), R49.2
unnamed: Q10.2 (S), U3.8 (IOUT)
unnamed: C13.1, R51.1, U3.7 (SET)
VCC: D17.1 (K), U3.5 (VCC); also elsewhere on the board

Notes on the sheet:
Salida 4-20mA

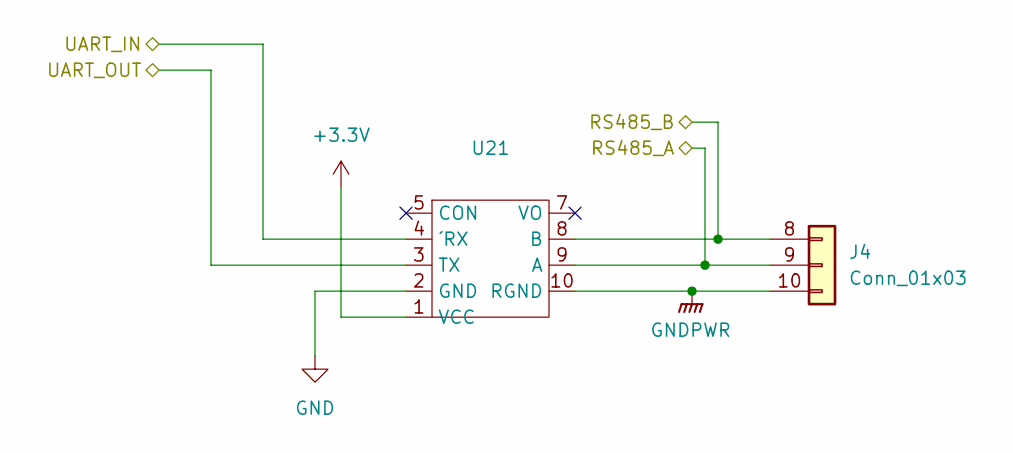
[picture p25: schematic RS485.kicad_sch]

Parts:
J4: Conn_01x03; PinHeader_1x03_P2.54mm_Vertical
U21: SOIC127P600X175-8N

Connections:
+3.3V: U21.1 (VCC); also elsewhere on the board
/Board-PLC4UNI-G1w/PLC4UNI_CPU/ESP32_UART_A: U21.4 (´RX); also elsewhere on the board
/Board-PLC4UNI-G1w/PLC4UNI_CPU/ESP32_UART_B: U21.3 (TX); also elsewhere on the board
/Board-PLC4UNI-G1w/RS485_B: J4.8 (Pin_1), U21.8 (B); also elsewhere on the board
GND: U21.2 (GND); also elsewhere on the board

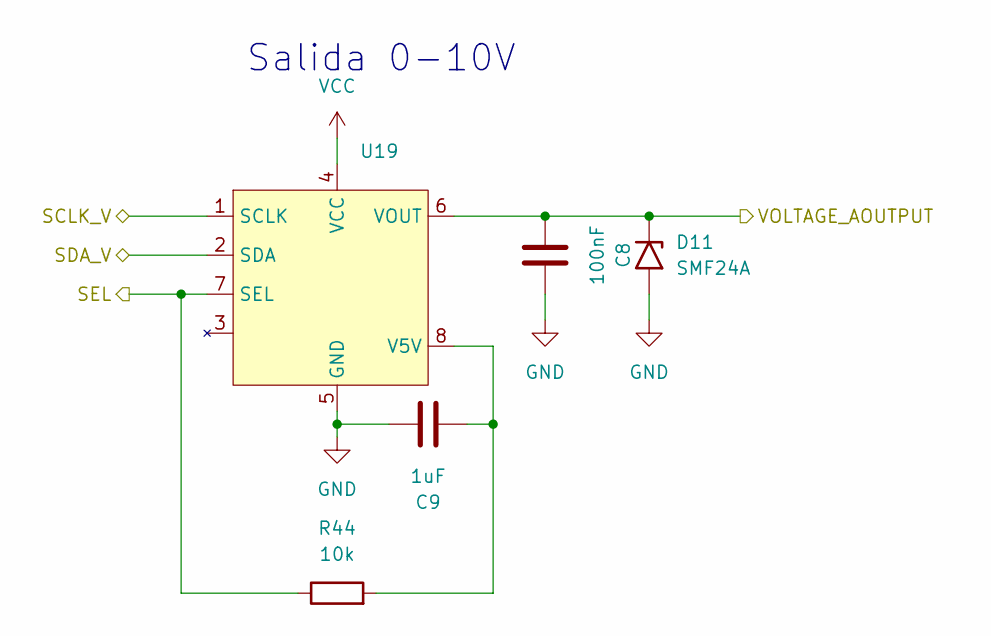
[picture p26: schematic 0-10V_Output.kicad_sch]

Parts:
C8: 100nF; C_0805_2012Metric
C9: 1uF; C_0805_2012Metric_Pad1.18x1.45mm_HandSolder
D11: SMF24A; D_SMF; LCSC# C7495269
R44: 10k; R_0603_1608Metric
U19: SOIC-8_5.3x5.3mm_P1.27mm

Connections:
/Board-PLC4UNI-G1w/0-10V_OUTPUT: C8.2, D11.1 (A1), U19.6 (VOUT); also elsewhere on the board
/Board-PLC4UNI-G1w/0-10V_Output/SCLK_V: U19.1 (SCLK); also elsewhere on the board
/Board-PLC4UNI-G1w/0-10V_Output/SDA_V: U19.2 (SDA); also elsewhere on the board
/Board-PLC4UNI-G1w/0-10V_Output/SEL: R44.1, U19.7 (SEL); also elsewhere on the board
GND: C8.1, C9.1, D11.2 (A2), U19.5 (GND); also elsewhere on the board
unnamed: C9.2, R44.2, U19.8 (V5V)
VCC: U19.4 (VCC); also elsewhere on the board

Notes on the sheet:
Salida 0-10V

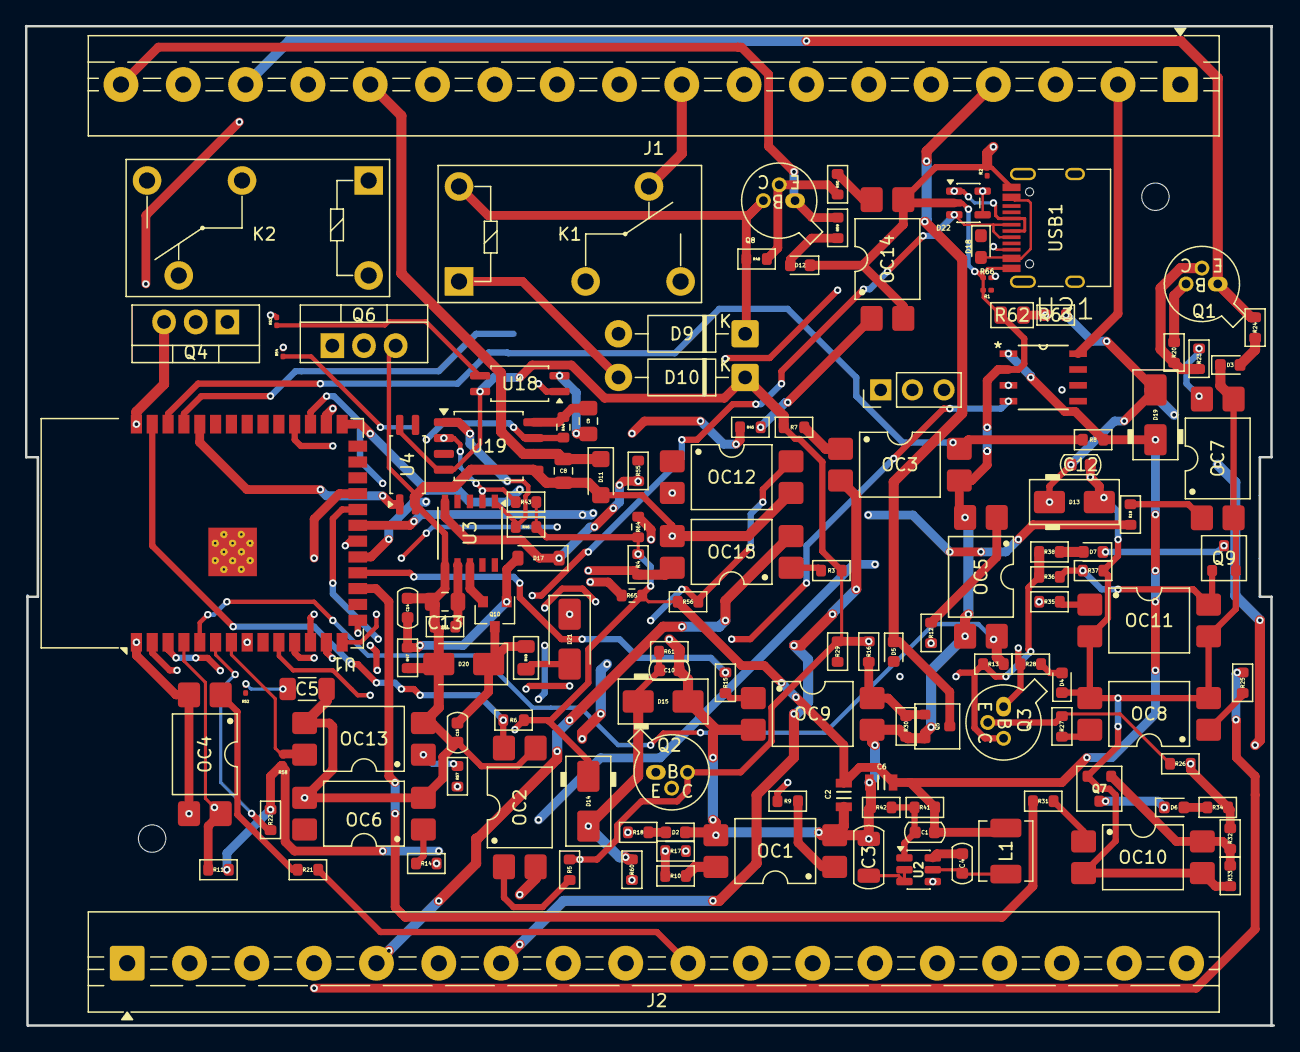
[picture p27: board PLC4UNI.kicad_pcb from above]

Board: 4 copper layers, 100.1 x 80.2 mm, 135 parts (0 on the bottom side), 107 nets.

Other parts of the board:
D10: 1N4001; D_DO-41_SOD81_P10.16mm_Horizontal
K1: G5Q-1; Relay_SPDT_Omron-G5Q-1
Q6: TIP41; TO-220-3_Vertical
R54: R_US; R_0201_0603Metric
U4: TLP290; SOP-4_4.4x2.6mm_P1.27mm

Their connections:
/Board-PLC4UNI-G1w/COM_B_RLY: K1.2; also elsewhere on the board
/Board-PLC4UNI-G1w/NC_B_RLY: K1.4; also elsewhere on the board
/Board-PLC4UNI-G1w/NO_B_RLY: K1.3; also elsewhere on the board
/Board-PLC4UNI-G1w/OUT_RLY_B/RLY_B_INR: U4.1; also elsewhere on the board
GND: Q6.3 (E), U4.2; also elsewhere on the board
unnamed: D10.2 (A), K1.1, Q6.2 (C)
unnamed: Q6.1 (B), R54.2
unnamed: R54.1, U4.3
VCC: D10.1 (K), K1.5, U4.4; also elsewhere on the board
