XadielM/Xadiel_Martinez_PLC4Uni/(commit log)

2025-09-26 Diseño del case en SolidEdge
2025-09-26 Diseño del plastic case
2025-10-03 Diseño plastic case
2025-10-08 Diseño PCB KiCad
    [PLC4UNI.kicad_pcb, PLC4UNI.kicad_sch]
2025-10-10 Tarea 2
    [Plastic Case PT1.FCStd, Plastic Case PT2.FCStd, Plastic Case PT3.FCStd]
2025-10-10 Tarea 3
    [PLC4UNI.kicad_pcb, PLC4UNI.kicad_sch]
2025-10-10 Investigacion de esquematico
2025-11-26 Tarea 3
    [0-10V_Output.kicad_sch, Board-PLC4UNI-G1w.kicad_sch, PLC4UNI.kicad_pcb, PLC4UNI.kicad_sch, PLC4UNI_CPU.kicad_sch, PowerSupply.kicad_sch, output_PNP.kicad_sch]
2025-12-05 tarea 3 - update
    [Board-PLC4UNI-G1w.kicad_sch, PLC4UNI.kicad_pcb, RS485.kicad_sch]
2025-12-08 Tarea - Update
    [4-20mA_Output.kicad_sch, Modulo USB.kicad_pcb, Modulo USB.kicad_sch]
2025-12-10 Tarea 4
    [Assembly.FCStd, Modulo USB.kicad_pcb]
2025-12-12 Tarea 4 - Update
    [Assembly.FCStd]
